jsloan256/titan/README.md

# Titan

Titan is a PCI Express development card for the Lattice ECP5 FPGA. Titan is designed to be a cost optimized starting point for designs that use the Lattice ECP5 FPGA. The PCB was routed using Altium Designer. Altium is a commerical PCB layout tool, but a free viewer is available (see Links below).

# Titan Goals
* Cost effective
* [Limited feature set](https://github.com/c-e-s/titan/wiki/Features)
* Fully validated design

titan-c

# Tools
* Altium Designer 15.0.15

# Links
* Altium PCB viewer: http://altium.com/en/products
* Lattice ECP5: http://www.latticesemi.com/ecp5
* Titan releases (gerbers and PDFs of schematic): https://github.com/c-e-s/titan/releases
