jsloan256/titan/(list of files, drawings)

Other design files:
003-00004.PrjPcb
003-00004.SchDoc
FT2232HQ_LATTICE_JTAG.SchDoc
Lattice_ECP5.SchDoc
Lattice_ECP5_power.SchDoc
MEC8_Expansion.SchDoc
MIC24085.SchDoc
Micron_DDR3_64Mx16.SchDoc
PCIe_x1_edge.SchDoc
