jsloan256/titan/(commit log)

2014-09-29 Added all Altium source files for Titan.
    We did the development for this project in a closed subversion system.
    From this point forward we expect to make our commits to this public
    git repo.
    [003-00004.PrjPcb, 003-00004.SchDoc, FT2232HQ_LATTICE_JTAG.SchDoc, Lattice_ECP5.SchDoc, Lattice_ECP5_power.SchDoc, MEC8_Expansion.SchDoc, MIC24085.SchDoc, Micron_DDR3_64Mx16.SchDoc]
2014-09-30 Imported OutJob files from enceladus (eccc266bfa)
    The OutJob files from enceladus have been updated to generate a 3D plot
    for documentation and the BOM format was changed to html.
    [003-00004.PrjPcb]
2014-09-30 Updated PCB from Schematic
    Some temporary net names were removed.
    Two components were substituted for BOM consolidation.
2014-11-06 Updated 003-00004 (PCB) and 001-00004 (Variant
    Updated 003-00004 (PCB) and 001-00004 (variant, including schematic and
    assembly) revisions. Both were A and both are now B
    [003-00004.PrjPcb]
2014-11-07 Moved the DDR3 decoupling caps away by 0.33mm
    The decoupling caps interfered with the placement of the DDR3 IC (U11).
    While moving the parts the teardrops were removed. They will be
    regenerated before rev B is released.
2014-11-07 Changed U1 footprint pad size
    Changed the ECP5 CSG324 footprint from 0.25mm to 0.34mm diameter pads.
    When soldered to the 0.25mm pads the ECP5 FPGA adhered poorly to the
    PCB. The 0.34mm pad size was chosen based on Altera AN114 application
    note (Table 3).
2014-11-07 Moved oscillator clock connection
    Moved the oscillator clock connection on the ECP5 from A19 to B12. A19
    was not a valid clock input.
    [Lattice_ECP5.SchDoc]
2014-11-07 Updated USB connector
    The original Samtec part is now obsolete.
    [003-00004.PrjPcb, FT2232HQ_LATTICE_JTAG.SchDoc]
2014-11-07 Various clean-up edits
    1. Removed silly DNC on ECP5 schematic page
    2. Changed 2x10 header to “Not Fitted”
    3. Fixed DDR3 trace clearance error
    [003-00004.PrjPcb, Lattice_ECP5.SchDoc]
2014-11-07 More cleanup
    1. Adjusted U12’s resistor placement (they were too close to have any
    solder mask between the different part’s pads)
    2. Moved C81 and C82 away from the crystal a bit
2014-11-07 Disconnected the FT2232HQ center pad.
    Removed the connection from the FT2232HQ center pad and ground. The
    datasheet does not specify what net the pad should be connected to. We
    found use cases of the FT2232HQ on On Semi reference cards (ie.
    EVBUM2216/D) that kept the pad isolated so we followed suit.
    [FT2232HQ_LATTICE_JTAG.SchDoc]
2014-11-07 Updated OutJobs
    The inner layers were not being generated with the gerbers.
2014-12-05 moved right board edge and EXP connectors 10mm to the right.
    Board outline updated
    Ground and power planes and keepouts updated
    Sliced tracks and moved connectors
2014-12-11 Rev C changes
    Reconnected expansion header nets
    Marked USB programming parts that are not required as DNP.
    Added UART connections to USB circuit
    Updated annotation
    Updated project parameters to reflect new Revision, Rev C
    [003-00004.PrjPcb, FT2232HQ_LATTICE_JTAG.SchDoc, Lattice_ECP5_power.SchDoc, MEC8_Expansion.SchDoc]
2014-12-12 Add 1.2V LDO
    Moved configuration pull ups and LEDs to make room for 1.2V LDO
    Added 1.2V LDO
    Initial update to express routing. Not quite happy with how close to
    other circuits they are.
    Routed UART connection.
    Major cleanup on USB power filter and crystal routing.
    [003-00004.PrjPcb, 003-00004.SchDoc, Lattice_ECP5.SchDoc, Lattice_ECP5_power.SchDoc]
2014-12-14 Initial length tuning on EXPA
    [Lattice_ECP5_power.SchDoc]
2014-12-15 Initial length tuning on EXPB and misc routing cleanup
    [Lattice_ECP5.SchDoc, Lattice_ECP5_power.SchDoc]
2015-01-02 Started evaluating new pinout for expansion headers
    [Lattice_ECP5.SchDoc]
2015-01-04 Cut outer P3 tracks and flipped the fanout via.
2015-01-04 Cut inner P3 tracks and flipped the fanout via.
2015-01-04 Cut outer P5 tracks and flipped the fanout via.
2015-01-04 Cut inner P5 tracks and flipped the fanout via.
2015-01-04 Updated P3 pinout to put DQ nets on the same side
    [Lattice_ECP5.SchDoc]
2015-01-04 Updated P3 pinout to put VREF on the edge.
    [Lattice_ECP5.SchDoc]
2015-01-15 Changed expansion pinout
    This is a first-cut re-assignment to test on the PCB.
    [003-00004.PrjPcb, Lattice_ECP5.SchDoc, MEC8_Expansion.SchDoc]
2015-01-15 Corrected expansion pinout & imported into the PCB
    [MEC8_Expansion.SchDoc]
2015-01-16 Expanded (roughly) board outline to ease routing.
2015-01-21 Routed "true TX" DQ pairs
    Routed “true TX” DQ pairs (DQ0 & DQ1 pairs on each expansion connector
    side). A few A/B pairs where swapped to ease routing. The only
    troublesome route is B_DQ1-1.
    [Lattice_ECP5.SchDoc]
2015-01-24 Routed remaining nets on P3
    Routed remaining nets on P3. Changed a few new assignments as needed to
    ease routing. The route still needs to be tuned.
    [Lattice_ECP5.SchDoc]
2015-01-24 Routed P5 "low priority" nets on layer 3
    [Lattice_ECP5.SchDoc]
2015-01-24 Routed P5 "low priority" nets on layer 6
    [Lattice_ECP5.SchDoc]
2015-01-29 Updated to AD15
    Updated to AD15. I recompiled the project, imported into the PCB, ad
    verified component links. No errors occurred and it looks like there
    were no actual changes.
2015-01-29 Added missing GND connection on a few vias
2015-03-06 Updated PCB outline (& related polys)
2015-03-06 Adjusted expansion routing to balance trace spacing.
2015-03-13 Corrected trace width (B_PCLK, B_DQ1-1)
2015-03-17 Tightened DDR3 data tuning (to within 100mils)
2015-03-26 Restored differential pair directive to DDR3 CK0 net
    [Micron_DDR3_64Mx16.SchDoc]
2015-03-27 Re-placed GND polys on layers 2 & 5
2015-03-28 Added and placed fiducials
    [003-00004.SchDoc]
2015-03-28 Moved R51 away from U11 to prevent assembly problems.
2015-03-29 Moved FPGA to ECP5-45 (from ECP5-85)
    The Lattice LFE5UM-45F-6BG381C is the actual part that we intend to
    build Titan with. During prototyping we had samples of the ECP5-85
    [Lattice_ECP5.SchDoc, Lattice_ECP5_power.SchDoc]
2015-03-29 Removed page 2 from the assembly drawing
2015-04-06 Added reference designator for P3 to the silkscreen
2015-04-07 Changed R69 to 49.9k to set U13's output to 1.2V
    [Lattice_ECP5_power.SchDoc]
2015-04-07 Exposed selected bottom side power via for testing
2015-04-07 Corrected solder mask relief over "Titan" text
2015-04-07 Set camera angle and DPI settings for 3D PDF output
    The DPI setting had to be dropped from 300 to 75 to prevent white lines
    from overlaying the image.
2015-04-07 Updated PCB image in README
2015-04-07 Added publish scripts
    These scripts are used to create a zipfile of the gerbers and to name
    the files in a consistent manner.
2015-04-08 Updated 017-00002 to pull in the new manufacturing information
    [FT2232HQ_LATTICE_JTAG.SchDoc]
